JMachacek460/NANO_PWM/dokument/obr/foto.jpg

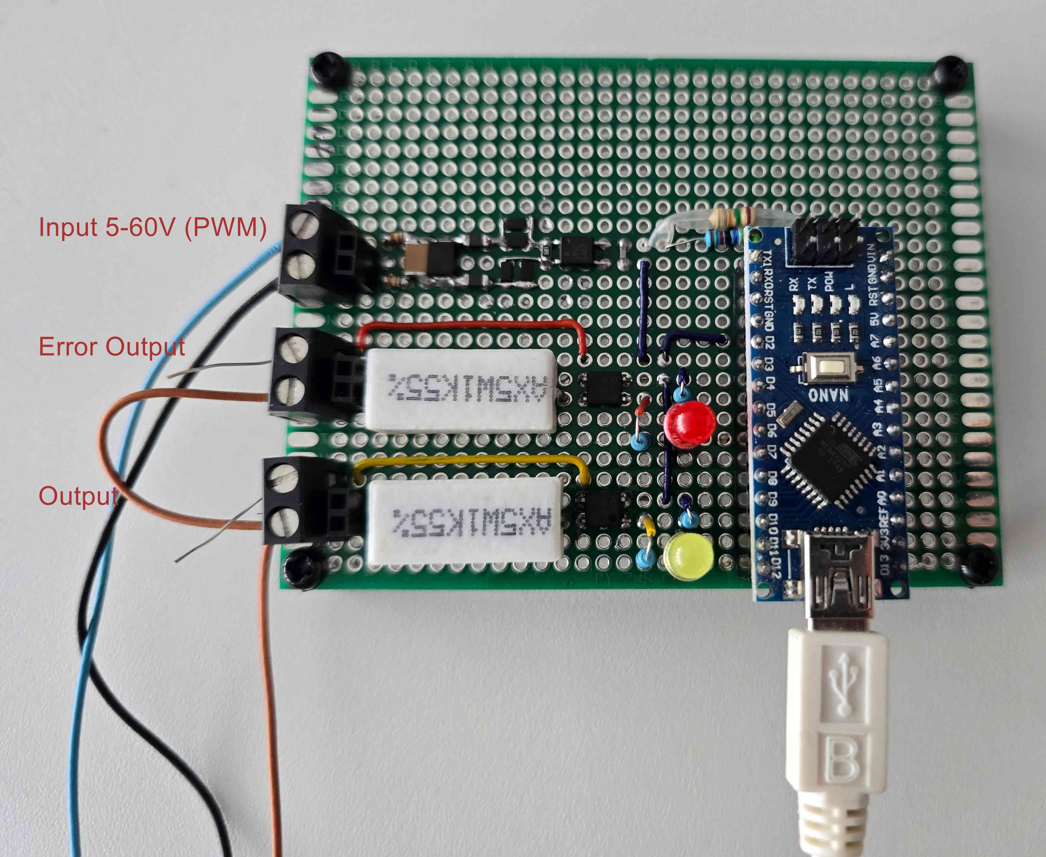
dokument/obr/foto.jpg
