JMachacek460/NANO_PWM/dokument/schema_AduinoNANO_PWM/wiring_diagram.asc

C1: cap; 470p
C2: cap; 1n
C3: cap; 1n
C4: cap; 100p
C5: cap; 470µ
CRD_1: CurDiode; #807897
CRD_2: CurDiode; #807897
CRD_3: CurDiode; #807897
CRD_4: CurDiode; #807897
D1: LED; LXHL-BW02; Yellow
D2: LED; LXHL-BW02; Red
L1: WE-TMSB
L2: WE-TMSB
R1: EuropeanResistor; 17R8 #326267
R2: EuropeanResistor; 17R8 #326267
R3: EuropeanResistor; 680
R4: EuropeanResistor; 15k
R5: EuropeanResistor; 47k
R6: EuropeanResistor; 220k
R7: EuropeanResistor; 1k
R8: EuropeanResistor; 1k
R9: EuropeanResistor; 1k/5W
R10: EuropeanResistor; 1k
R11: EuropeanResistor; 1k
R12: EuropeanResistor; 1k/5W
X1: bidirect; D3
X2: Optoclen
X3: Optorele
X4: Optorele
Named nets: 0, Input_, Arduino_Pin2, Input, Arduino_Pin12, Output, Arduino_Pin6, Error_out
Arduino 5V
Arduino GND
filters pulses approx. 30us
ArduinoNano
R1,R2     #326267 R17R8 1% T50 S M0207 MF
C1,C4      #9196795 C100P 500V 5% COG SCH1206H016
D3           #116881 NSU68 BS SM6T68CA DO214AA
L1 L2       #70124924 FERRIT S 1000R/100 1A40 CH1206
CRD 1-4  #807897 NK5.00 S S-562T SOD123FL
Optocop  #70196151 OCPL S LTV-354T SOP4   
R6            #018496 R220K 1% T200 S CH1206 MF
C5            #052980 C470U 16V 20%ALEL C115080 3P5
C2,C3       #550360 C1N 50V 5% COG SCH0603H008
Optorele  #70120618 OCPL S AQY210KSX SO4
R7,R8,R10,R11 - 1k 0603 or THT
R4 15k  0603 or THT
R5  47k 0603 or THT
#909768 PTB02 5.00 1.50SC00BK1TR MKDSN  (terminal block)
885 352 211 001 1
Wurth
#70196151 OCPL S LTV-354T
#116881
NSU68 BS SM6T68CA
#70124924
#70124924
PWM 5-60V
Arduino GND
#70120618 OCPL S AQY210KSX SO4
Arduino GND
#70120618 OCPL S AQY210KSX SO4
Evaluating PWM signals using Arduino NANO
